infovore/RadioMusic/RadioMusicHardware/RadioMusic_B.brd

## EAGLE design RadioMusicHardware/RadioMusic_B.brd (2019-08-05)

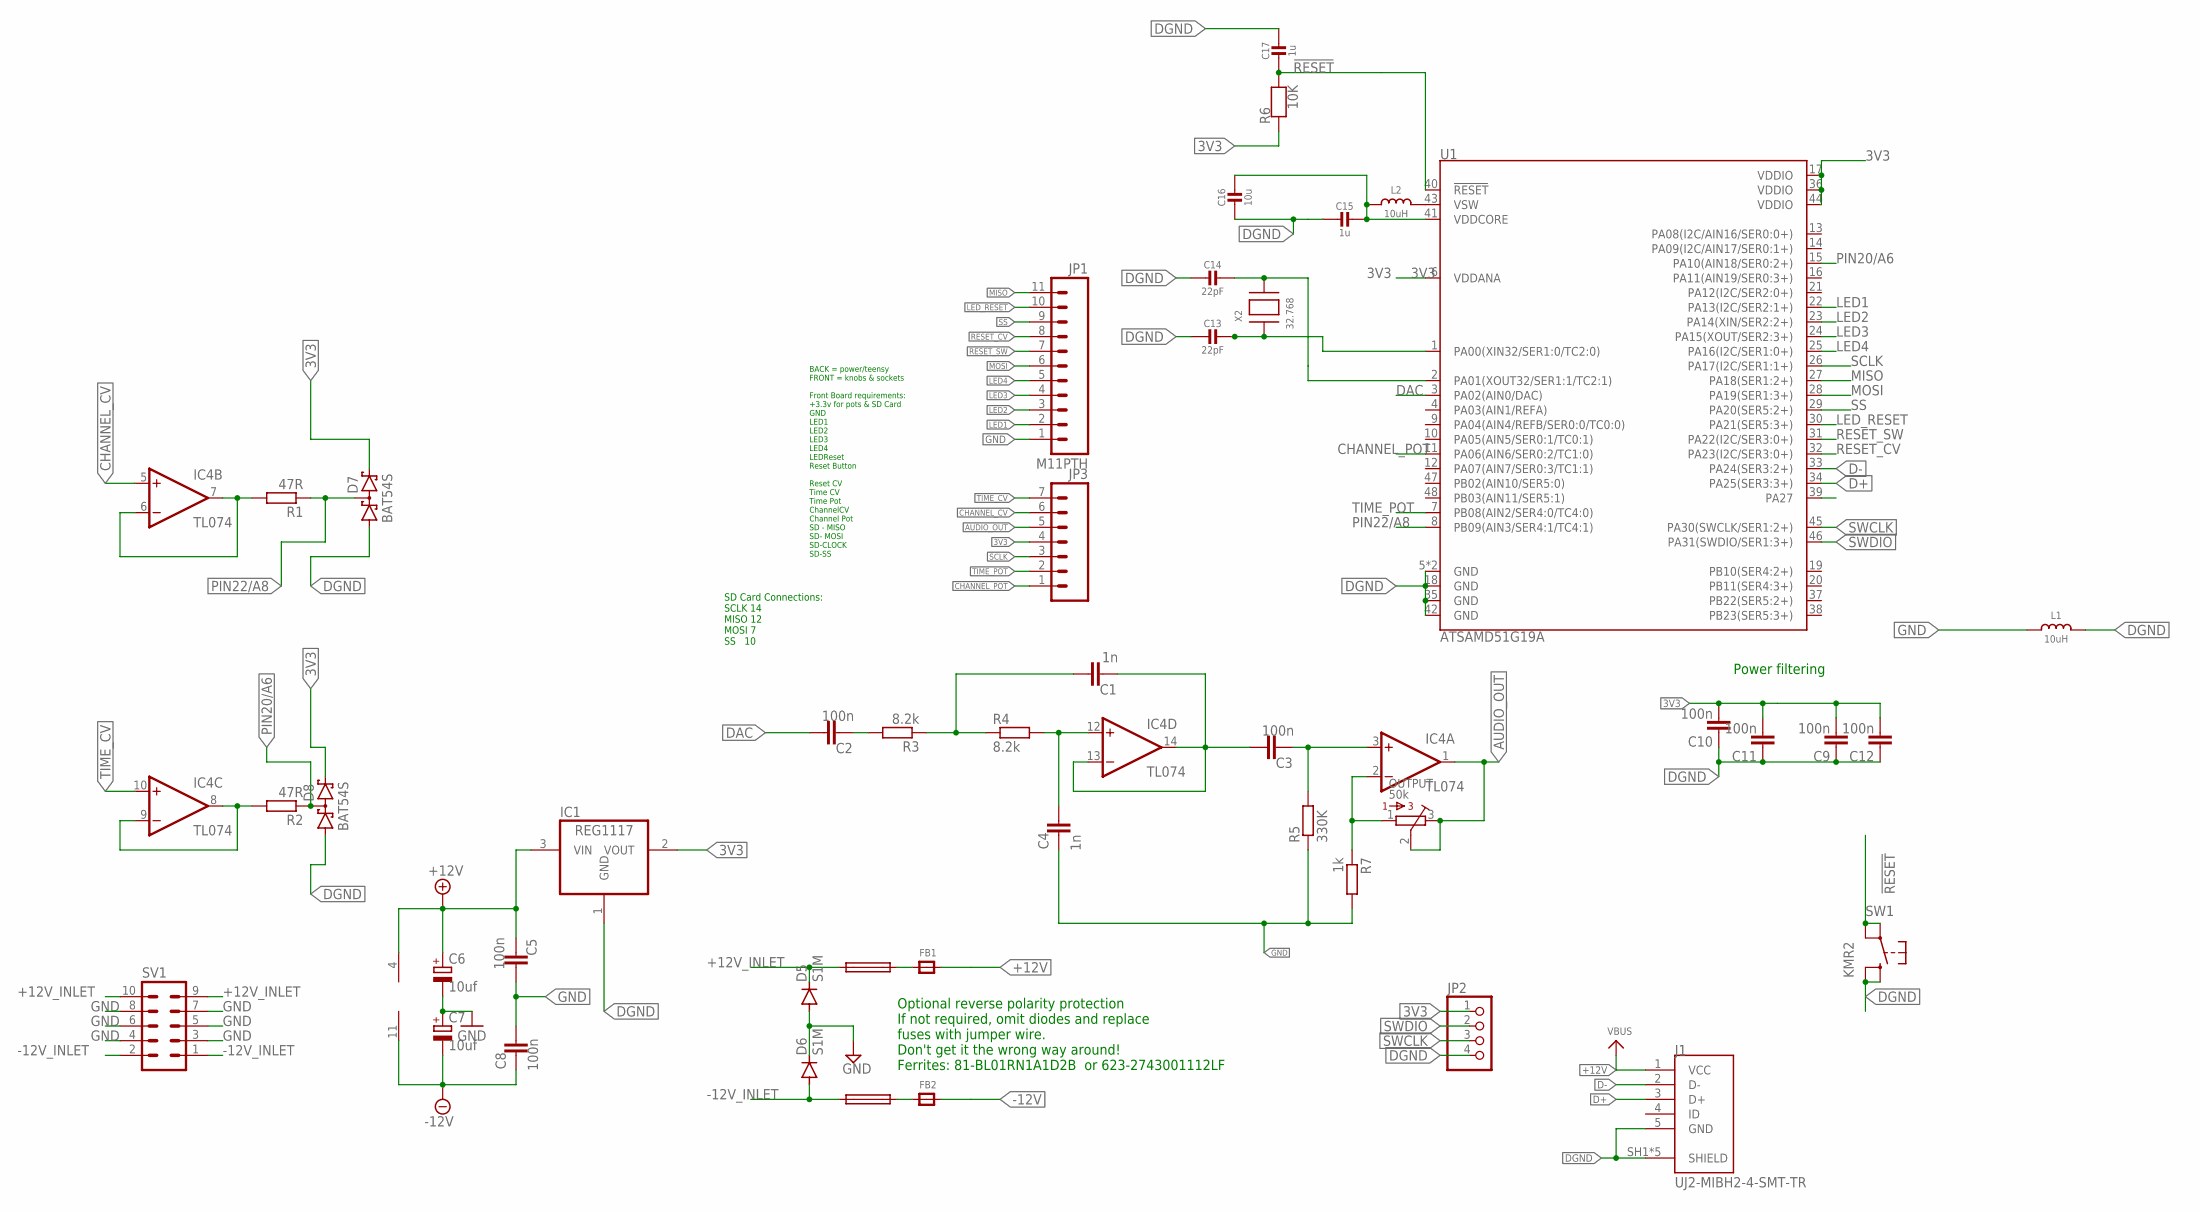
[picture p1: schematic RadioMusic_B.sch]

Parts:
C1, C4: 1n; C0603
C2, C3, C5, C8, C9, C10, C11, C12: 100n; C0603
C6, C7: 10uf; PANASONIC_B
C13, C14: 22pF; 0603-NO
C15, C17: 1u; 0603-NO
C16: 10u; 0805-NO
D5, D6: S1M; SMA
D7, D8: BAT54S; SOT23
F1, F2: FUSE; F1206
FB1, FB2: FERRITE_0805; _0805
IC1: REG1117; SOT223
IC4: TL074; SO14
J1: UJ2-MIBH2-4-SMT-TR; CUI_UJ2-MIBH2-4-SMT-TR
JP1: M11PTH; 1X11
JP2: PINHD-1X4; 1X04
JP3: M07; 1X07
L1, L2: 10uH; INDUCTOR_1007
OUTPUT: 50k; 3362P
R1, R2: 47R; R0603
R3, R4: 8.2k; R0603
R5: 330K; R0603
R6: 10K; 0603-NO
R7: 1k; R0603
SV1: 10_PIN_HEADER; MA05-2
SW1: KMR2; BTN_KMR2_4.6X2.8
U1: ATSAMD51G19A; QFN-48
X2: 32.768; XTAL3215

Connections:
3V3: C9.2, C10.2, C11.2, C12.2, C15.1, C16.1, D7.2 (C2), D8.2 (C2), IC1.2 (VOUT), JP2.1, JP3.4, L2.P$1 (1), R6.1, U1.6 (VDDANA), U1.17 (VDDIO), U1.36 (VDDIO), U1.41 (VDDCORE), U1.44 (VDDIO)
!RESET: C17.2, R6.2, SW1.A, SW1.A' (P1), U1.40 (!RESET!)
+12V: C5.2, C6.+, FB1.2, IC1.3 (VIN), IC4.4 (V+), J1.1 (VCC)
+12V_INLET: D5.C, F1.1, SV1.9, SV1.10
-12V: C7.-, C8.2, FB2.2, IC4.11 (V-)
-12V_INLET: D6.A, F2.1, SV1.1, SV1.2
AUDIO_OUT: IC4.1 (OUT), JP3.5, OUTPUT.2, OUTPUT.3
CHANNEL_CV: IC4.5 (+IN), JP3.6
CHANNEL_POT: JP3.1, U1.11 (PA06(AIN6/SER0:2/TC1:0))
D+: J1.3 (D+), U1.34 (PA25(SER3:3+))
D-: J1.2 (D-), U1.33 (PA24(SER3:2+))
DAC: C2.1, U1.3 (PA02(AIN0/DAC))
DGND: C9.1, C10.1, C11.1, C12.1, C13.2, C14.2, C15.2, C16.2, C17.1, D7.1 (A1), D8.1 (A1), IC1.1 (GND), J1.5 (GND), J1.SH1 (SHIELD), J1.SH2 (SHIELD), J1.SH3 (SHIELD), J1.SH4 (SHIELD), J1.SH5 (SHIELD), JP2.4, L1.P$2 (2), SW1.B (S), SW1.B' (S1), U1.5 (GND), U1.18 (GND), U1.35 (GND), U1.42 (GND), U1.EP (GND)
GND: C4.2, C5.1, C6.-, C7.+, C8.1, D5.A, D6.C, JP1.1, L1.P$1 (1), R5.1, R7.2, SV1.3, SV1.4, SV1.5, SV1.6, SV1.7, SV1.8
LED1: JP1.2, U1.22 (PA13(I2C/SER2:1+))
LED2: JP1.3, U1.23 (PA14(XIN/SER2:2+))
LED3: JP1.4, U1.24 (PA15(XOUT/SER2:3+))
LED4: JP1.5, U1.25 (PA16(I2C/SER1:0+))
LED_RESET: JP1.10, U1.30 (PA21(SER5:3+))
MISO: JP1.11, U1.27 (PA18(SER1:2+))
MOSI: JP1.6, U1.28 (PA19(SER1:3+))
unnamed: IC4.8 (OUT), IC4.9 (-IN), R2.2
unnamed: C4.1, IC4.12 (+IN), R4.2
unnamed: IC4.6 (-IN), IC4.7 (OUT), R1.2
unnamed: C1.1, R3.1, R4.1
unnamed: C1.2, C3.1, IC4.13 (-IN), IC4.14 (OUT)
unnamed: C3.2, IC4.3 (+IN), R5.2
unnamed: IC4.2 (-IN), OUTPUT.1, R7.1
unnamed: C13.1, U1.1 (PA00(XIN32/SER1:0/TC2:0)), X2.P$1
unnamed: C14.1, U1.2 (PA01(XOUT32/SER1:1/TC2:1)), X2.P$2
unnamed: C2.2, R3.2
unnamed: L2.P$2 (2), U1.43 (VSW)
unnamed: F1.2, FB1.1
unnamed: F2.2, FB2.1
PIN20/A6: D8.3 (C1A2), R2.1, U1.15 (PA10(AIN18/SER0:2+))
PIN22/A8: D7.3 (C1A2), R1.1, U1.8 (PB09(AIN3/SER4:1/TC4:1))
RESET_CV: JP1.8, U1.32 (PA23(I2C/SER3:0+))
RESET_SW: JP1.7, U1.31 (PA22(I2C/SER3:0+))
SCLK: JP3.3, U1.26 (PA17(I2C/SER1:1+))
SS: JP1.9, U1.29 (PA20(SER5:2+))
SWCLK: JP2.3, U1.45 (PA30(SWCLK/SER1:2+))
SWDIO: JP2.2, U1.46 (PA31(SWDIO/SER1:3+))
TIME_CV: IC4.10 (+IN), JP3.7
TIME_POT: JP3.2, U1.7 (PB08(AIN2/SER4:0/TC4:0))

Notes on the sheet:
Optional reverse polarity protection If not required, omit diodes and replace fuses with jumper wire. Don't get it the wrong way around! Ferrites: 81-BL01RN1A1D2B or 623-2743001112LF
SD Card Connections: SCLK 14 MISO 12 MOSI 7 SS 10
BACK = power/teensy FRONT = knobs & sockets Front Board requirements: +3.3v for pots & SD Card GND LED1 LED2 LED3 LED4 LEDReset Reset Button Reset CV Time CV Time Pot ChannelCV Channel Pot SD - MISO SD- MOSI SD-CLOCK SD-SS
Power filtering

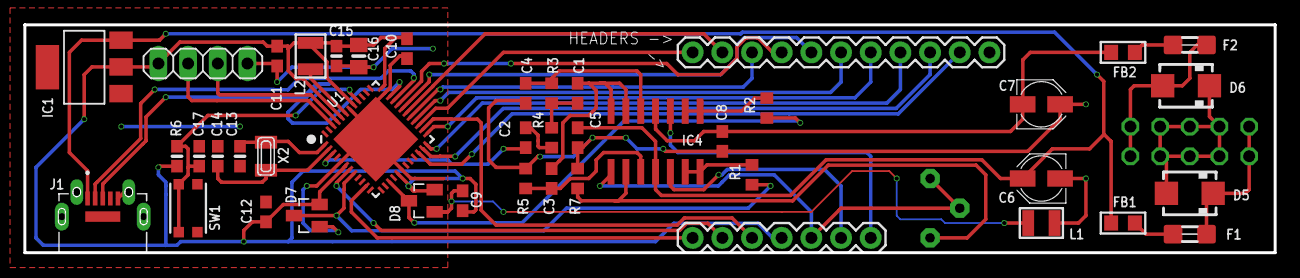
[picture p2: board RadioMusic_B.brd from above]

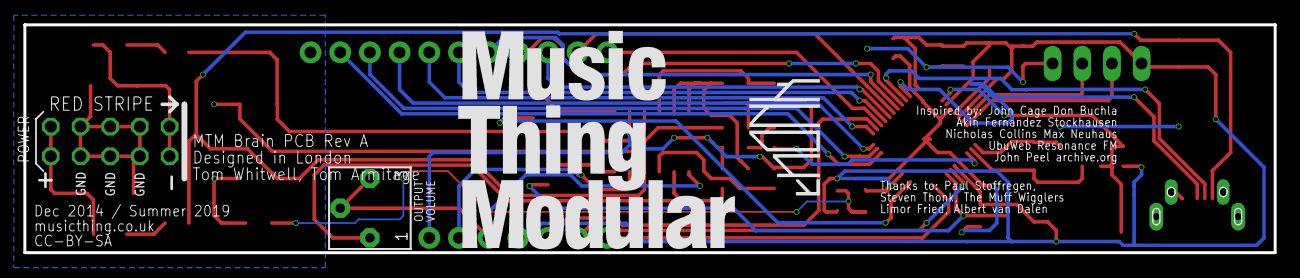
[picture p3: board RadioMusic_B.brd from below]

Board: 2 copper layers, 107.0 x 19.5 mm, 47 parts (4 on the bottom side), 44 nets.

Other parts of the board:
U$2: THONK_1CM_SCREENPRINT
U$4: MTM_2CM
