infovore/RadioMusic/(commit log)

2019-05-07 WIP on a SAMD51 back board.
    [RadioMusic_B.brd, RadioMusic_B.sch]
2019-06-03 Rear Board for SAMD51.
    [RadioMusic_B.brd, RadioMusic_B.sch]
2019-06-03 Fixup Firmware for Adafruit boards:
    * use Adafruit Audio library
    * explicitly reference elapsedMillis
    * use FlashStorage fork to replace lack of EEPROM
    * don't use non-existent analog pins
    [AudioEngine.h, AudioSystemHelpers.h, Interface.cpp, Interface.h, LedControl.h, RadioMusic.ino]
2019-06-04 Tidying silking.
    [RadioMusic_B.brd]
2019-06-04 Correct pinouts for M4 Express
    [Interface.h, LedControl.h, RadioMusic.ino]
2019-06-05 Connect DGND/GND via inductor. Tidy silking.
    [RadioMusic_B.brd, RadioMusic_B.sch]
2019-08-05 Rev A of MTM Brain board.
    [RadioMusic_B.brd, RadioMusic_B.sch]
