infovore/RadioMusic/(notices)

Notices in the files:
RadioMusicHardware/RadioMusic_B.brd:
CC-BY-SA
parts and their libraries:
SparkFun-Connectors: Licensing: CC v3.0 Share-Alike You are welcome to use this library for commercial purposes.
SparkFun-IC-Microcontroller: Licensing: Creative Commons ShareAlike 4.0 International - https://creativecommons.org/licenses/by-sa/4.0
